pdaxrom/PYLDIN601-HD6303/docs/hdmsspi.md

# Драйвер светодиодного дисплея

Дисплей использует 4 светодиодных дисплея по 8 символов, подключенных к порту SPI.

## Запуск

`hdmsspi`

Драйвер создает символьное устройство вывода `disp`.

## Использование

Копирование текста из файла на дисплей:

`copy hello.txt disp:`
