pdaxrom/PYLDIN601-HD6303/docs/README.md

# Новый Пълдин-601

Это проект 8-битного компьютера, программно совместимого с Пълдин-601 на уровне приложений. 

[Видео на Youtube](https://www.youtube.com/watch?v=-_IdSySlPXs)

IMAGE ALT TEXT HERE (https://www.youtube.com/watch?v=-_IdSySlPXs)

Проект включает в себя не только аппаратную часть, но и BIOS, системные ПЗУ, операционную систему и утилиты для работы с обновленным железом.

## Устройство компьютера

Минимальная рабочая конфигурация требует только [плату процессора](cpu-mem.md), источник питания 5 вольт и последовательный порт (с пятивольтовыми уровнями). Для полноценной работы с возможностью использования клавиатуры, дисплея, sd карты, звука, необходима [плата периферии](ext-mod.md).

[Плата процессора](cpu-mem.md)

[Плата периферии](ext-mod.md)

## Программное обеспечение

[Базовая система и системный монитор](https://pyldin.info/document/unibios_rus.htm)

[Графический редактор GD]()

[Игры]()

[Обучающие программы]()

[Операционная система UniDOS](https://pyldin.info/document/unidos_rus.htm)

[Текстовый редактор UniED](https://pyldin.info/document/unied_rus.htm)

[Утилиты](utils.md)

[Языки программирования и инструменты разработчика](devtools.md)

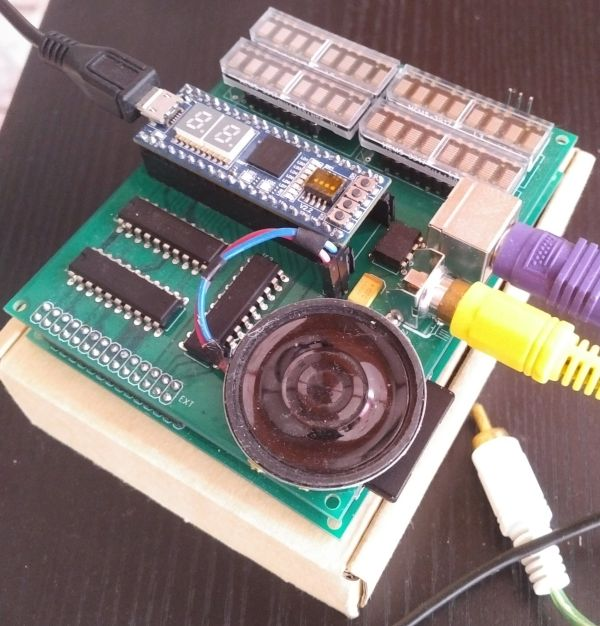
[picture p1: docs/lil-hw.jpg]
