pdaxrom/PYLDIN601-HD6303/docs/upc.md

# Компилятор UniPASCAL

## Документация

[UniPASCAL часть 1](https://pyldin.info/document/unipas_rus.htm)

[UniPASCAL часть 2](https://pyldin.info/document/unipas2_rus.htm)

## Пример

[Видео на Youtube](https://www.youtube.com/watch?v=55ygb4fnvvE)

IMAGE ALT TEXT HERE (https://www.youtube.com/watch?v=55ygb4fnvvE)
