pdaxrom/PYLDIN601-HD6303/docs/devtools.md

## Средства разработки

### Ассемблер

[UniAS](unias.md) является основным и главным системным ассемблером, поддерживающим новые команды процессора HD6303 и используется для сборки все системных прошивок ПЗУ, UniDOS и утилит.

[Ассемблер UniAS](unias.md)

[Ассемблер UniASM](https://pyldin.info/document/uniasm_rus.htm)

[Ассемблер UniCross](https://pyldin.info/document/unicross_rus.htm)

### Интерпретатор Basic

[UniBASIC](https://pyldin.info/document/unibasic_rus.htm)

### Компилятор C

[Small-C](small-c.md)

### Компилятор Паскаля

[UniPASCAL](upc.md)

### Среда разработки ТриЛого

### Среда разработки Фея
