pdaxrom/PYLDIN601-HD6303/docs/p601egrf.md

# Эмулятор графических режимов Пълдин-601

Обновленный компьютер использует другой тип видеоконтроллера и устройства видеопамяти.
Чтобы старые приложения могли корректно работать, им требуется данный эмулятор.
Текущая версия эмулятора поддерживает работу с графическими режимами, устанавливаемыми
через системные вызовы UniBIOS. Прямая работа с регистрами видеоконтроллера MC6845 не
поддерживается.

## Запуск

`p601egrf`
