pdaxrom/PYLDIN601-HD6303/docs/sdformat.md

# Форматирование SD карты

Утилита `sdformat` используется для создания файловой системы на карте памяти. Размер созданной файловой системы - 16 МБ. Для
загрузки с карты, скопируйте на нее командный интерпретатор UniDOS.CMD.

## Запуск

`sdformat`
