pdaxrom/PYLDIN601-HD6303/docs/utils.md

# Утилиты

[Драйвер светодиодного дисплея](hdmsspi.md)

[Форматирование SD карты](sdformat.md)

[Эмулятор графических режимов Пълдин-601](p601egrf.md)
