pdaxrom/PYLDIN601-HD6303/HW/hd6303-mb-ram-rom-x1.3.brd

## EAGLE design HW/hd6303-mb-ram-rom-x1.3.brd (2019-05-04)

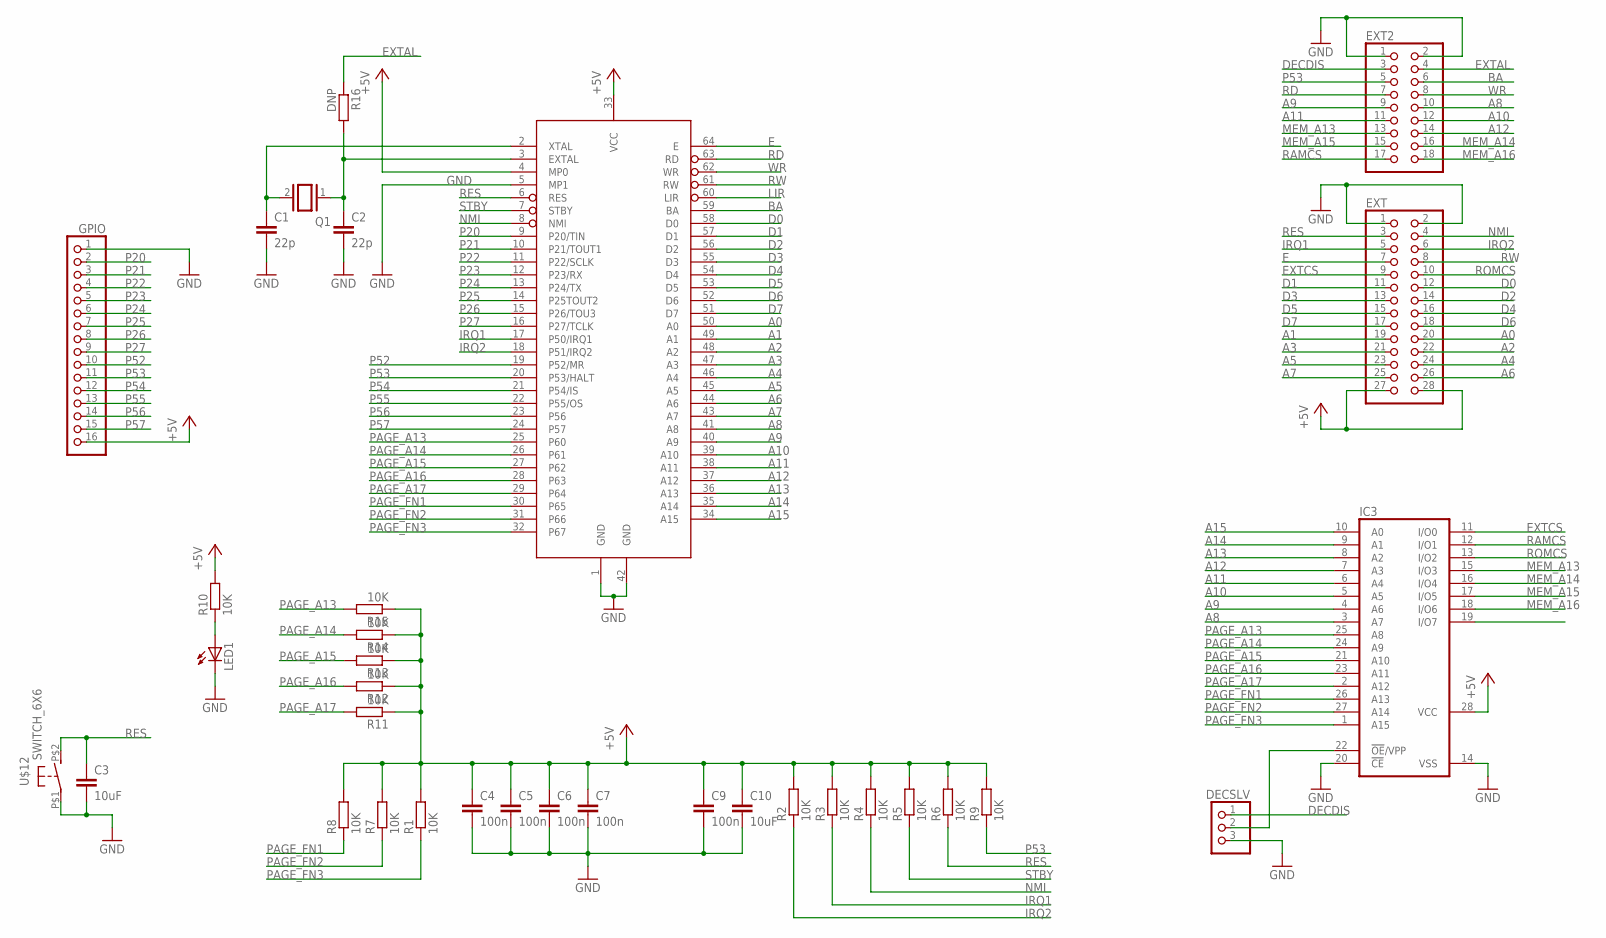
[picture p4: schematic hd6303-mb-ram-rom-x1.3.sch, sheet 1]

Parts:
C1, C2: 22p; C0603
C3, C10: 10uF; C0805
C4, C5, C6, C7, C9: 100n; C0603
DECSLV: PINHD-1X3; 1X03
EXT: PINHD-2X14; 2X14
EXT2: PINHD-2X9; 2X09
GPIO: PINHD-1X16; 1X16
IC3: 27512G; DIL28-6
LED1: LED5MM
Q1: XTAL/S; QS
R1, R2, R3, R4, R5, R6, R7, R8, R9, R10, R11, R12, R13, R14, R15: 10K; R0603
R16: DNP; R0603
U$1: HD6303YCP; DP-64S
U$12: SWITCH_6X6

Connections:
+5V: C4.1, C5.1, C6.1, C7.1, C9.1, C10.1, EXT.27, EXT.28, GPIO.16, IC3.28 (VCC), R1.2, R2.2, R3.2, R4.2, R5.2, R6.2, R7.2, R8.2, R9.2, R10.2, R11.1, R12.1, R13.1, R14.1, R15.1, U$1.4 (MP0), U$1.33 (VCC); also elsewhere on the board
A0: EXT.20, U$1.50 (A0); also elsewhere on the board
A1: EXT.19, U$1.49 (A1); also elsewhere on the board
A2: EXT.22, U$1.48 (A2); also elsewhere on the board
A3: EXT.21, U$1.47 (A3); also elsewhere on the board
A4: EXT.24, U$1.46 (A4); also elsewhere on the board
A5: EXT.23, U$1.45 (A5); also elsewhere on the board
A6: EXT.26, U$1.44 (A6); also elsewhere on the board
A7: EXT.25, U$1.43 (A7); also elsewhere on the board
A8: EXT2.10, IC3.3 (A7), U$1.41 (A8); also elsewhere on the board
A9: EXT2.9, IC3.4 (A6), U$1.40 (A9); also elsewhere on the board
A10: EXT2.12, IC3.5 (A5), U$1.39 (A10); also elsewhere on the board
A11: EXT2.11, IC3.6 (A4), U$1.38 (A11); also elsewhere on the board
A12: EXT2.14, IC3.7 (A3), U$1.37 (A12); also elsewhere on the board
A13: IC3.8 (A2), U$1.36 (A13)
A14: IC3.9 (A1), U$1.35 (A14)
A15: IC3.10 (A0), U$1.34 (A15)
BA: EXT2.6, U$1.59 (BA)
D0: EXT.12, U$1.58 (D0); also elsewhere on the board
D1: EXT.11, U$1.57 (D1); also elsewhere on the board
D2: EXT.14, U$1.56 (D2); also elsewhere on the board
D3: EXT.13, U$1.55 (D3); also elsewhere on the board
D4: EXT.16, U$1.54 (D4); also elsewhere on the board
D5: EXT.15, U$1.53 (D5); also elsewhere on the board
D6: EXT.18, U$1.52 (D6); also elsewhere on the board
D7: EXT.17, U$1.51 (D7); also elsewhere on the board
DECDIS: DECSLV.1, EXT2.3
E: EXT.7, U$1.64 (E)
EXTAL: EXT2.4, R16.1
EXTCS: EXT.9, IC3.11 (I/O0)
GND: C1.2, C2.2, C3.2, C4.2, C5.2, C6.2, C7.2, C9.2, C10.2, DECSLV.3, EXT.1, EXT.2, EXT2.1, EXT2.2, GPIO.1, IC3.14 (VSS), IC3.20 (!CE), LED1.K (C), U$1.1 (GND), U$1.5 (MP1), U$1.42 (GND), U$12.P$1; also elsewhere on the board
IRQ1: EXT.5, R3.1, U$1.17 (P50/IRQ1)
IRQ2: EXT.6, R2.1, U$1.18 (P51/IRQ2)
LIR: U$1.60 (LIR)
MEM_A13: EXT2.13, IC3.15 (I/O3); also elsewhere on the board
MEM_A14: EXT2.16, IC3.16 (I/O4); also elsewhere on the board
MEM_A15: EXT2.15, IC3.17 (I/O5); also elsewhere on the board
MEM_A16: EXT2.18, IC3.18 (I/O6); also elsewhere on the board
unnamed: LED1.A, R10.1
unnamed: DECSLV.2, IC3.22 (!OE!/VPP)
unnamed: C1.1, Q1.2, U$1.2 (XTAL)
unnamed: C2.1, Q1.1, R16.2, U$1.3 (EXTAL)
NMI: EXT.4, R4.1, U$1.8 (NMI)
P20: GPIO.2, U$1.9 (P20/TIN)
P21: GPIO.3, U$1.10 (P21/TOUT1)
P22: GPIO.4, U$1.11 (P22/SCLK)
P23: GPIO.5, U$1.12 (P23/RX)
P24: GPIO.6, U$1.13 (P24/TX)
P25: GPIO.7, U$1.14 (P25TOUT2)
P26: GPIO.8, U$1.15 (P26/TOU3)
P27: GPIO.9, U$1.16 (P27/TCLK)
P52: GPIO.10, U$1.19 (P52/MR)
P53: EXT2.5, GPIO.11, R9.1, U$1.20 (P53/HALT)
P54: GPIO.12, U$1.21 (P54/IS)
P55: GPIO.13, U$1.22 (P55/OS)
P56: GPIO.14, U$1.23 (P56)
P57: GPIO.15, U$1.24 (P57)
PAGE_A13: IC3.25 (A8), R15.2, U$1.25 (P60)
PAGE_A14: IC3.24 (A9), R14.2, U$1.26 (P61)
PAGE_A15: IC3.21 (A10), R13.2, U$1.27 (P62)
PAGE_A16: IC3.23 (A11), R12.2, U$1.28 (P63)
PAGE_A17: IC3.2 (A12), R11.2, U$1.29 (P64)
PAGE_FN1: IC3.26 (A13), R8.1, U$1.30 (P65)
PAGE_FN2: IC3.27 (A14), R7.1, U$1.31 (P66)
PAGE_FN3: IC3.1 (A15), R1.1, U$1.32 (P67)
RAMCS: EXT2.17, IC3.12 (I/O1); also elsewhere on the board
RD: EXT2.7, U$1.63 (RD); also elsewhere on the board
RES: C3.1, EXT.3, R6.1, U$1.6 (RES), U$12.P$2 (S)
ROMCS: EXT.10, IC3.13 (I/O2); also elsewhere on the board
RW: EXT.8, U$1.61 (RW)
STBY: R5.1, U$1.7 (STBY)
WR: EXT2.8, U$1.62 (WR); also elsewhere on the board

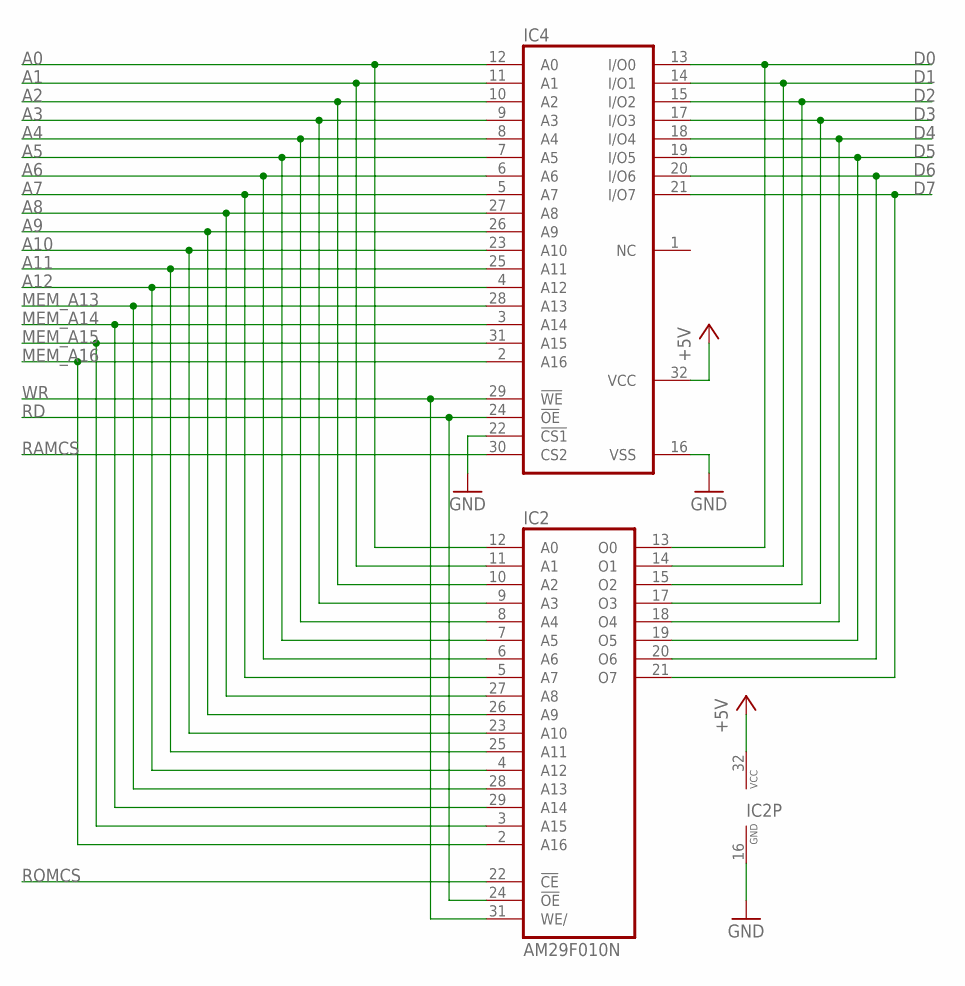
[picture p5: schematic hd6303-mb-ram-rom-x1.3.sch, sheet 2]

Parts:
IC2: AM29F010N; DIP32
IC4: 628128P; DIL32

Connections:
+5V: IC2.32 (VCC), IC4.32 (VCC); also elsewhere on the board
A0: IC2.12 (A0), IC4.12 (A0); also elsewhere on the board
A1: IC2.11 (A1), IC4.11 (A1); also elsewhere on the board
A2: IC2.10 (A2), IC4.10 (A2); also elsewhere on the board
A3: IC2.9 (A3), IC4.9 (A3); also elsewhere on the board
A4: IC2.8 (A4), IC4.8 (A4); also elsewhere on the board
A5: IC2.7 (A5), IC4.7 (A5); also elsewhere on the board
A6: IC2.6 (A6), IC4.6 (A6); also elsewhere on the board
A7: IC2.5 (A7), IC4.5 (A7); also elsewhere on the board
A8: IC2.27 (A8), IC4.27 (A8); also elsewhere on the board
A9: IC2.26 (A9), IC4.26 (A9); also elsewhere on the board
A10: IC2.23 (A10), IC4.23 (A10); also elsewhere on the board
A11: IC2.25 (A11), IC4.25 (A11); also elsewhere on the board
A12: IC2.4 (A12), IC4.4 (A12); also elsewhere on the board
D0: IC2.13 (O0), IC4.13 (I/O0); also elsewhere on the board
D1: IC2.14 (O1), IC4.14 (I/O1); also elsewhere on the board
D2: IC2.15 (O2), IC4.15 (I/O2); also elsewhere on the board
D3: IC2.17 (O3), IC4.17 (I/O3); also elsewhere on the board
D4: IC2.18 (O4), IC4.18 (I/O4); also elsewhere on the board
D5: IC2.19 (O5), IC4.19 (I/O5); also elsewhere on the board
D6: IC2.20 (O6), IC4.20 (I/O6); also elsewhere on the board
D7: IC2.21 (O7), IC4.21 (I/O7); also elsewhere on the board
GND: IC2.16 (GND), IC4.16 (VSS), IC4.22 (!CS1); also elsewhere on the board
MEM_A13: IC2.28 (A13), IC4.28 (A13); also elsewhere on the board
MEM_A14: IC2.29 (A14), IC4.3 (A14); also elsewhere on the board
MEM_A15: IC2.3 (A15), IC4.31 (A15); also elsewhere on the board
MEM_A16: IC2.2 (A16), IC4.2 (A16); also elsewhere on the board
RAMCS: IC4.30 (CS2); also elsewhere on the board
RD: IC2.24 (!OE), IC4.24 (!OE); also elsewhere on the board
ROMCS: IC2.22 (!CE); also elsewhere on the board
WR: IC2.31 (WE/), IC4.29 (!WE); also elsewhere on the board

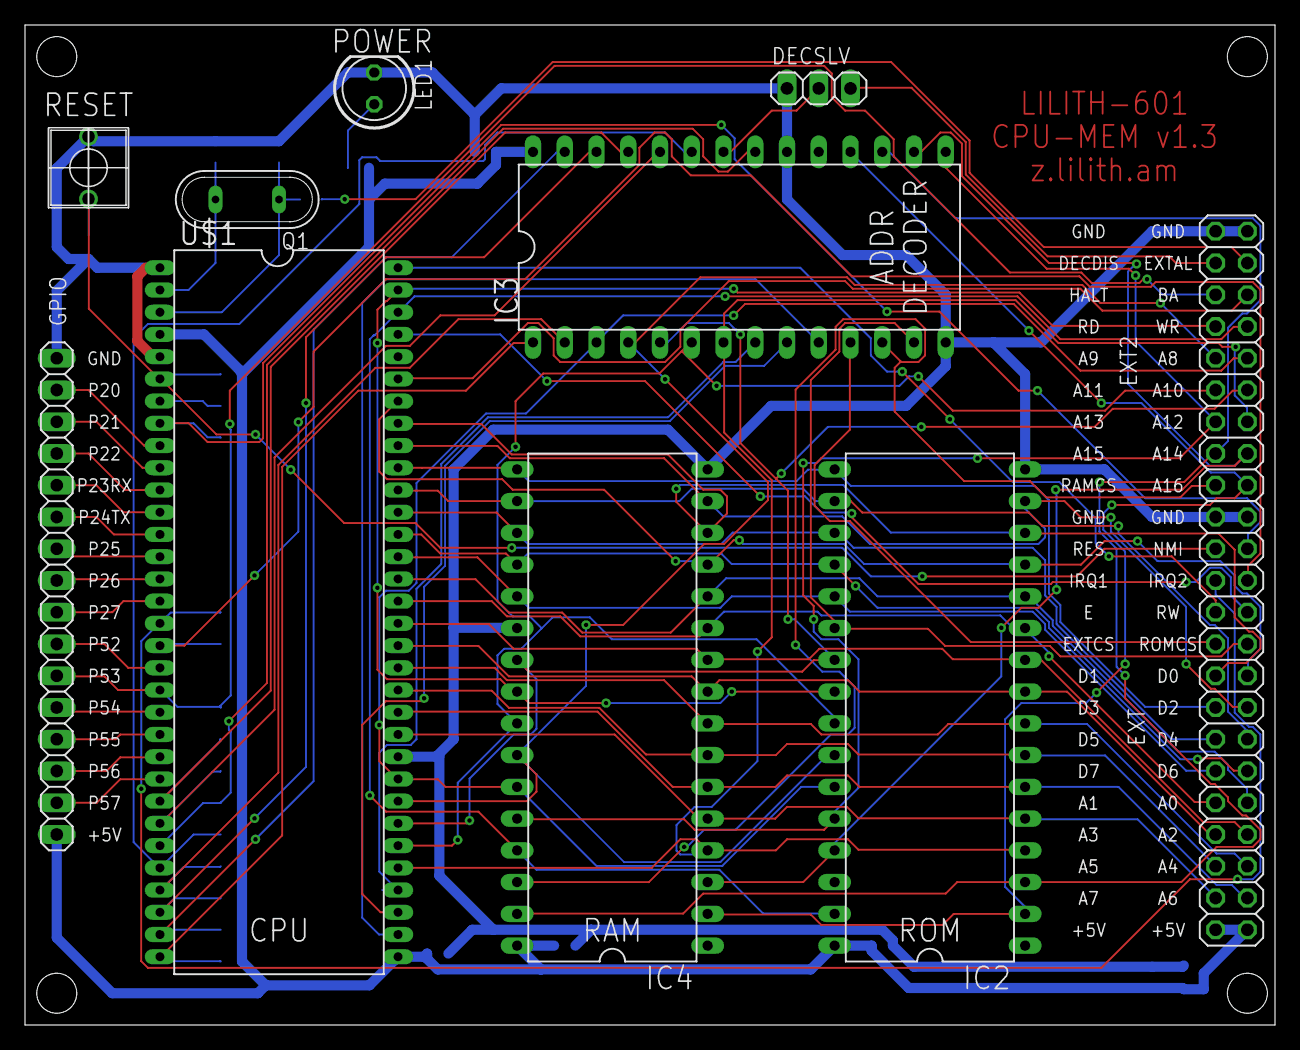
[picture p6: board hd6303-mb-ram-rom-x1.3.brd from above]

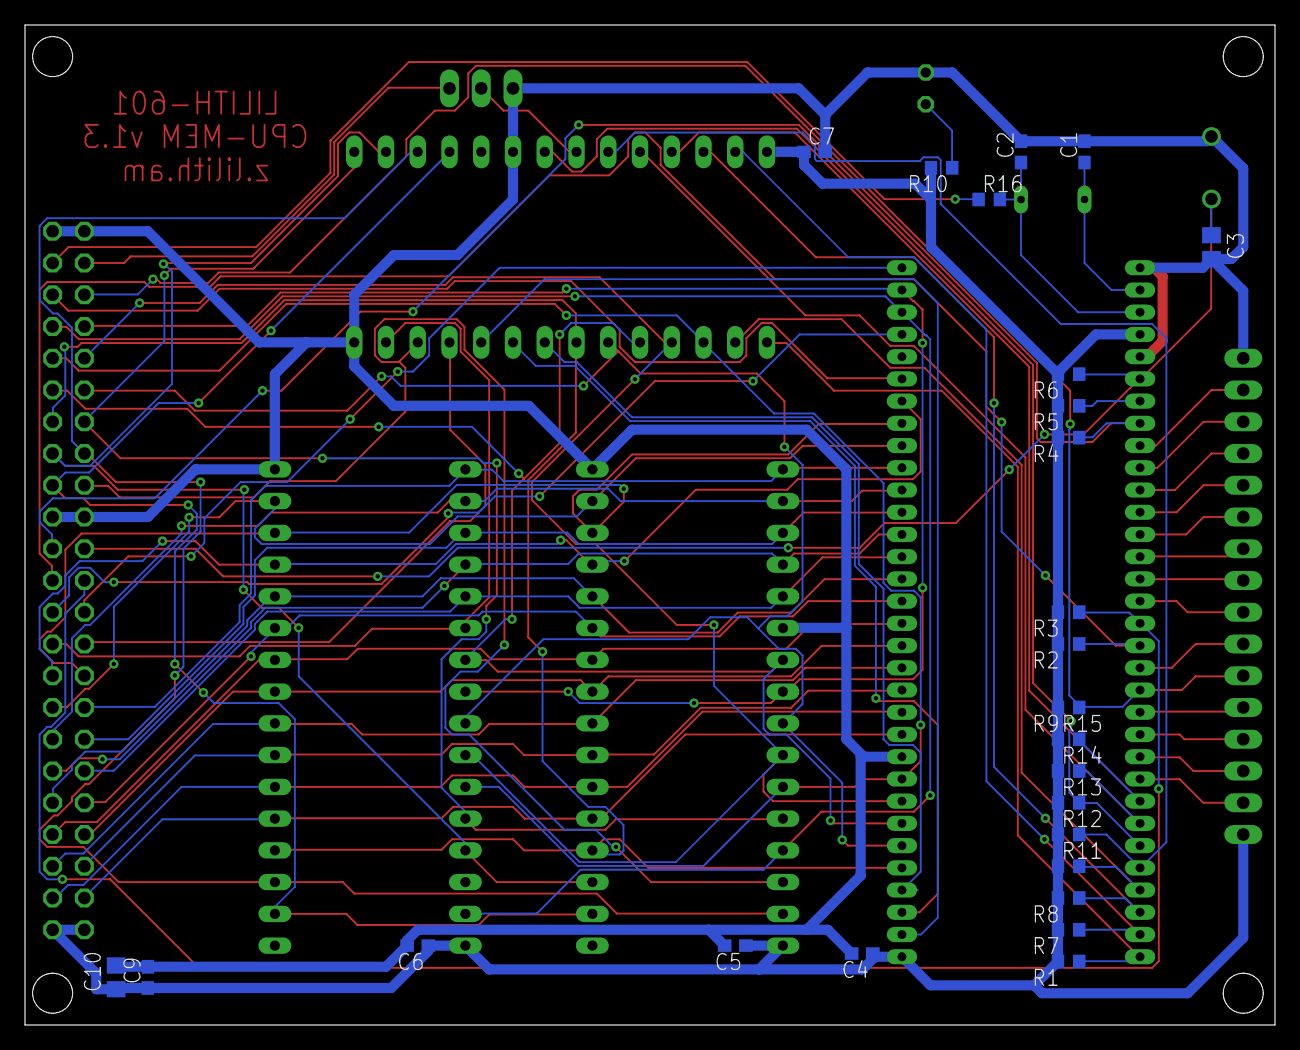
[picture p7: board hd6303-mb-ram-rom-x1.3.brd from below]

Board: 2 copper layers, 100.0 x 80.0 mm, 36 parts (25 on the bottom side), 71 nets.
