pdaxrom/PYLDIN601-HD6303/HW/hd6303-exp-x1.brd

## EAGLE design HW/hd6303-exp-x1.brd (2019-05-04)

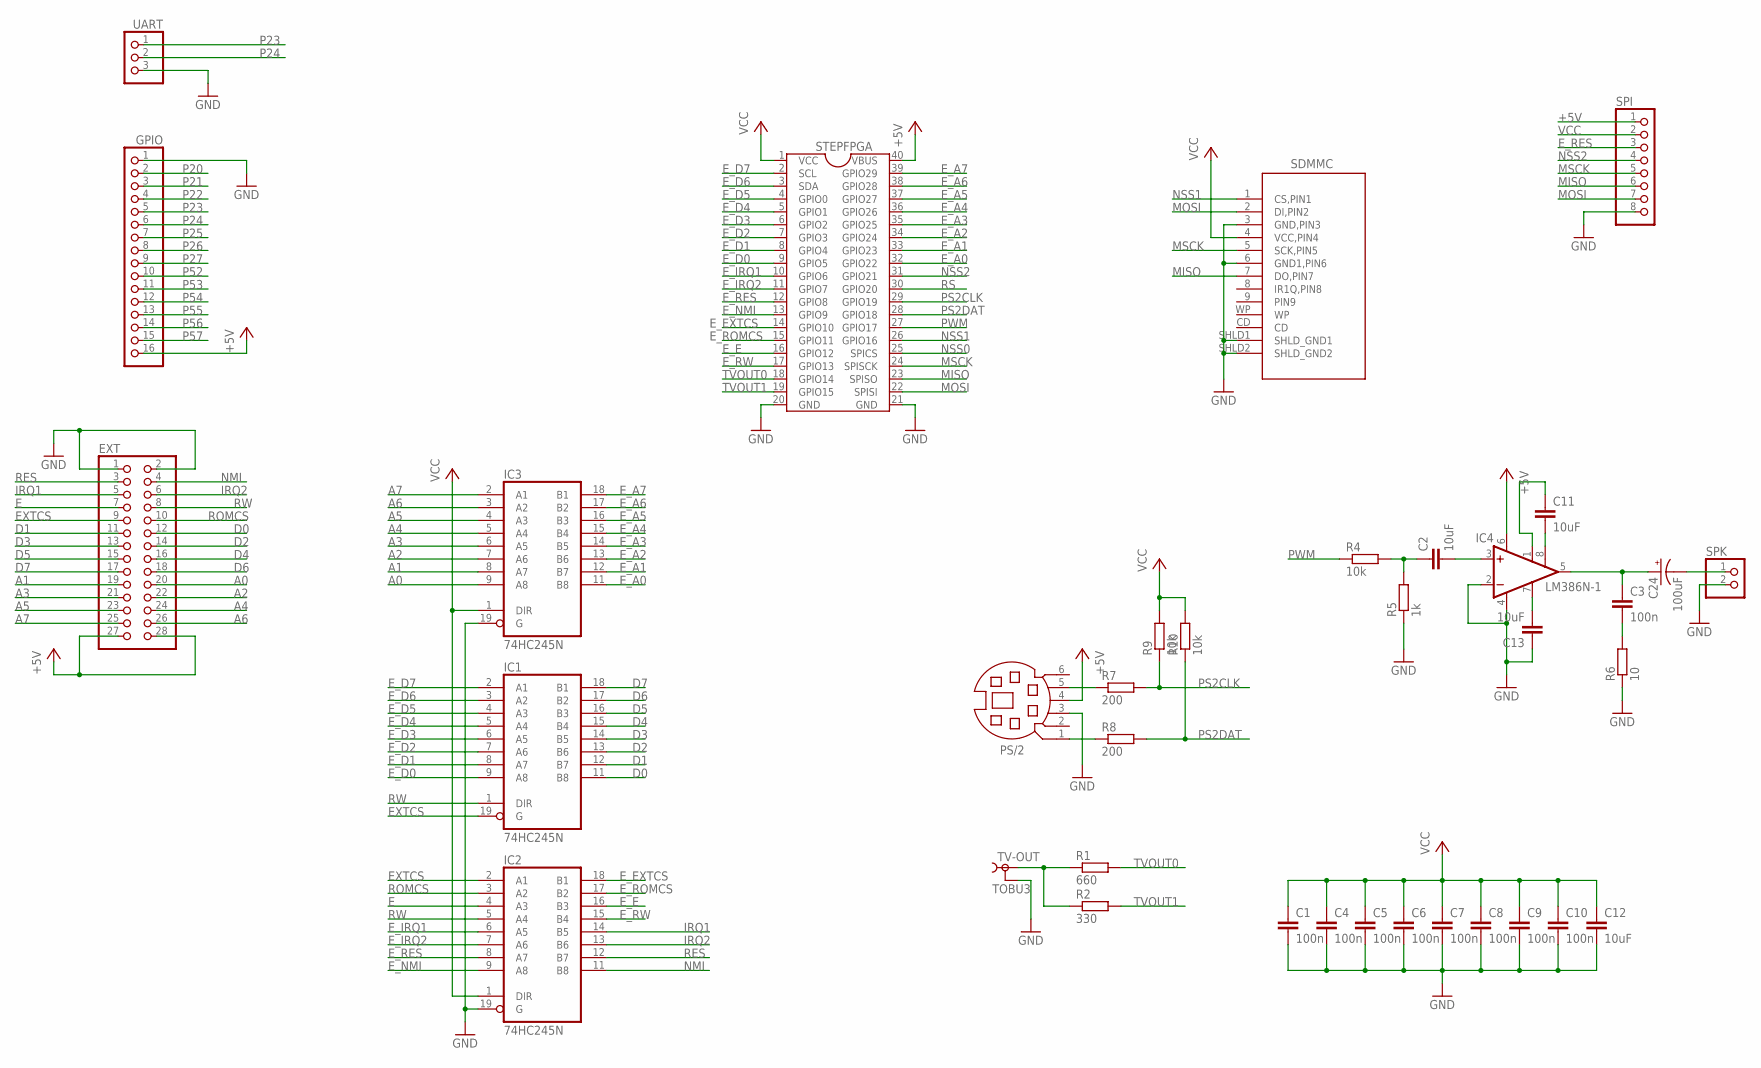
[picture p8: schematic hd6303-exp-x1.sch, sheet 1]

Parts:
C1, C3, C4, C5, C6, C7, C8, C9, C10: 100n; C0603
C2, C11, C12, C13: 10uF; C0805
C24: 100uF; EIA7343
EXT: PINHD-2X14; 2X14
GPIO: PINHD-1X16; 1X16
IC1, IC2, IC3: 74HC245N; DIL20
IC4: LM386N-1; DIL08
PS/2: MD06SS; MDIN06SS
R1: 660; R0603
R2: 330; R0603
R4, R9, R10: 10k; R0603
R5: 1k; R0603
R6: 10; R0603
R7, R8: 200; R0603
SDMMC: FCI_SD_SOCKET; SD-MMC_SOCKET-PP
SPI: PINHD-1X8; 1X08
SPK: PINHD-1X2; 1X02
STEPFPGA: STEPFPGA; DIL40
TV-OUT: TOBU3
UART: PINHD-1X3; 1X03

Connections:
+5V: EXT.27, EXT.28, GPIO.16, IC4.6 (VS), PS/2.4, SPI.1, STEPFPGA.40 (VBUS)
A0: EXT.20, IC3.9 (A8)
A1: EXT.19, IC3.8 (A7)
A2: EXT.22, IC3.7 (A6)
A3: EXT.21, IC3.6 (A5)
A4: EXT.24, IC3.5 (A4)
A5: EXT.23, IC3.4 (A3)
A6: EXT.26, IC3.3 (A2)
A7: EXT.25, IC3.2 (A1)
D0: EXT.12, IC1.11 (B8)
D1: EXT.11, IC1.12 (B7)
D2: EXT.14, IC1.13 (B6)
D3: EXT.13, IC1.14 (B5)
D4: EXT.16, IC1.15 (B4)
D5: EXT.15, IC1.16 (B3)
D6: EXT.18, IC1.17 (B2)
D7: EXT.17, IC1.18 (B1)
E: EXT.7, IC2.4 (A3)
EXTCS: EXT.9, IC1.19 (G), IC2.2 (A1)
E_A0: IC3.11 (B8), STEPFPGA.32 (GPIO22)
E_A1: IC3.12 (B7), STEPFPGA.33 (GPIO23)
E_A2: IC3.13 (B6), STEPFPGA.34 (GPIO24)
E_A3: IC3.14 (B5), STEPFPGA.35 (GPIO25)
E_A4: IC3.15 (B4), STEPFPGA.36 (GPIO26)
E_A5: IC3.16 (B3), STEPFPGA.37 (GPIO27)
E_A6: IC3.17 (B2), STEPFPGA.38 (GPIO28)
E_A7: IC3.18 (B1), STEPFPGA.39 (GPIO29)
E_D0: IC1.9 (A8), STEPFPGA.9 (GPIO5)
E_D1: IC1.8 (A7), STEPFPGA.8 (GPIO4)
E_D2: IC1.7 (A6), STEPFPGA.7 (GPIO3)
E_D3: IC1.6 (A5), STEPFPGA.6 (GPIO2)
E_D4: IC1.5 (A4), STEPFPGA.5 (GPIO1)
E_D5: IC1.4 (A3), STEPFPGA.4 (GPIO0)
E_D6: IC1.3 (A2), STEPFPGA.3 (SDA)
E_D7: IC1.2 (A1), STEPFPGA.2 (SCL)
E_E: IC2.16 (B3), STEPFPGA.16 (GPIO12)
E_EXTCS: IC2.18 (B1), STEPFPGA.14 (GPIO10)
E_IRQ1: IC2.6 (A5), STEPFPGA.10 (GPIO6)
E_IRQ2: IC2.7 (A6), STEPFPGA.11 (GPIO7)
E_NMI: IC2.9 (A8), STEPFPGA.13 (GPIO9)
E_RES: IC2.8 (A7), SPI.3, STEPFPGA.12 (GPIO8); also elsewhere on the board
E_ROMCS: IC2.17 (B2), STEPFPGA.15 (GPIO11)
E_RW: IC2.15 (B4), STEPFPGA.17 (GPIO13)
GND: C1.2, C4.2, C5.2, C6.2, C7.2, C8.2, C9.2, C10.2, C12.2, C13.1, EXT.1, EXT.2, GPIO.1, IC1.10 (GND), IC2.10 (GND), IC2.19 (G), IC3.10 (GND), IC3.19 (G), IC4.2 (-IN), IC4.4 (GND), PS/2.3, R5.1, R6.1, SDMMC.3 (GND,PIN3), SDMMC.6 (GND1,PIN6), SDMMC.SHLD1 (SHLD_GND1), SDMMC.SHLD2 (SHLD_GND2), SPI.8, SPK.2, STEPFPGA.20 (GND), STEPFPGA.21 (GND), TV-OUT.2, TV-OUT.2@1 (2), TV-OUT.2@2 (2), UART.3; also elsewhere on the board
IRQ1: EXT.5, IC2.14 (B5)
IRQ2: EXT.6, IC2.13 (B6)
MISO: SDMMC.7 (DO,PIN7), SPI.6, STEPFPGA.23 (SPISO)
MOSI: SDMMC.2 (DI,PIN2), SPI.7, STEPFPGA.22 (SPISI); also elsewhere on the board
MSCK: SDMMC.5 (SCK,PIN5), SPI.5, STEPFPGA.24 (SPISCK); also elsewhere on the board
unnamed: C2.2, IC4.3 (+IN)
unnamed: C2.1, R4.2, R5.2
unnamed: R1.1, R2.1, TV-OUT.1
unnamed: C3.1, C24.A (+), IC4.5 (OUT)
unnamed: C3.2, R6.2
unnamed: C11.1, IC4.1 (GAIN)
unnamed: C11.2, IC4.8 (GAIN)
unnamed: C24.C (-), SPK.1
unnamed: C13.2, IC4.7 (BYPASS)
unnamed: PS/2.5, R7.1
unnamed: PS/2.1, R8.1
NMI: EXT.4, IC2.11 (B8)
NSS0: STEPFPGA.25 (SPICS); also elsewhere on the board
NSS1: SDMMC.1 (CS,PIN1), STEPFPGA.26 (GPIO16)
NSS2: SPI.4, STEPFPGA.31 (GPIO21)
P20: GPIO.2
P21: GPIO.3
P22: GPIO.4
P23: GPIO.5, UART.1
P24: GPIO.6, UART.2
P25: GPIO.7
P26: GPIO.8
P27: GPIO.9
P52: GPIO.10
P53: GPIO.11
P54: GPIO.12
P55: GPIO.13
P56: GPIO.14
P57: GPIO.15
PS2CLK: R7.2, R9.1, STEPFPGA.29 (GPIO19)
PS2DAT: R8.2, R10.1, STEPFPGA.28 (GPIO18)
PWM: R4.1, STEPFPGA.27 (GPIO17)
RES: EXT.3, IC2.12 (B7)
ROMCS: EXT.10, IC2.3 (A2)
RS: STEPFPGA.30 (GPIO20); also elsewhere on the board
RW: EXT.8, IC1.1 (DIR), IC2.5 (A4)
TVOUT0: R1.2, STEPFPGA.18 (GPIO14)
TVOUT1: R2.2, STEPFPGA.19 (GPIO15)
VCC: C1.1, C4.1, C5.1, C6.1, C7.1, C8.1, C9.1, C10.1, C12.1, IC1.20 (VCC), IC2.1 (DIR), IC2.20 (VCC), IC3.1 (DIR), IC3.20 (VCC), R9.2, R10.2, SDMMC.4 (VCC,PIN4), SPI.2, STEPFPGA.1 (VCC); also elsewhere on the board

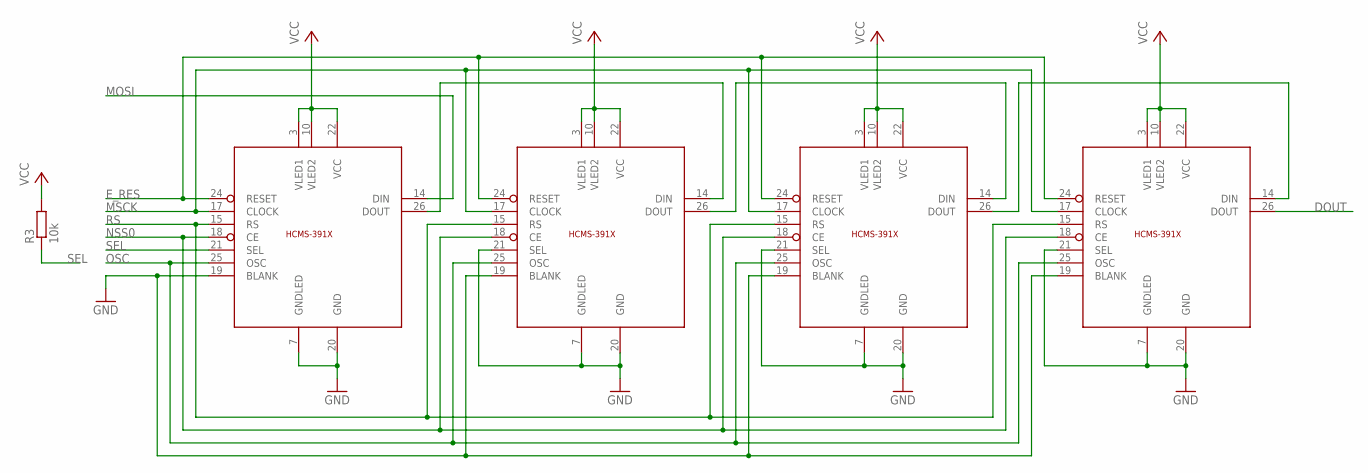
[picture p9: schematic hd6303-exp-x1.sch, sheet 2]

Parts:
R3: 10k; R0603
U$1, U$2, U$3, U$4: HCMS-391X

Connections:
DOUT: U$4.26 (DOUT)
E_RES: U$1.24 (RESET), U$2.24 (RESET), U$3.24 (RESET), U$4.24 (RESET); also elsewhere on the board
GND: U$1.7 (GNDLED), U$1.19 (BLANK), U$1.20 (GND), U$2.7 (GNDLED), U$2.19 (BLANK), U$2.20 (GND), U$2.21 (SEL), U$3.7 (GNDLED), U$3.19 (BLANK), U$3.20 (GND), U$3.21 (SEL), U$4.7 (GNDLED), U$4.19 (BLANK), U$4.20 (GND), U$4.21 (SEL); also elsewhere on the board
MOSI: U$1.14 (DIN); also elsewhere on the board
MSCK: U$1.17 (CLOCK), U$2.17 (CLOCK), U$3.17 (CLOCK), U$4.17 (CLOCK); also elsewhere on the board
unnamed: U$1.26 (DOUT), U$2.14 (DIN)
unnamed: U$2.26 (DOUT), U$3.14 (DIN)
unnamed: U$3.26 (DOUT), U$4.14 (DIN)
NSS0: U$1.18 (CE), U$2.18 (CE), U$3.18 (CE), U$4.18 (CE); also elsewhere on the board
OSC: U$1.25 (OSC), U$2.25 (OSC), U$3.25 (OSC), U$4.25 (OSC)
RS: U$1.15 (RS), U$2.15 (RS), U$3.15 (RS), U$4.15 (RS); also elsewhere on the board
SEL: R3.1, U$1.21 (SEL)
VCC: R3.2, U$1.3 (VLED1), U$1.10 (VLED2), U$1.22 (VCC), U$2.3 (VLED1), U$2.10 (VLED2), U$2.22 (VCC), U$3.3 (VLED1), U$3.10 (VLED2), U$3.22 (VCC), U$4.3 (VLED1), U$4.10 (VLED2), U$4.22 (VCC); also elsewhere on the board

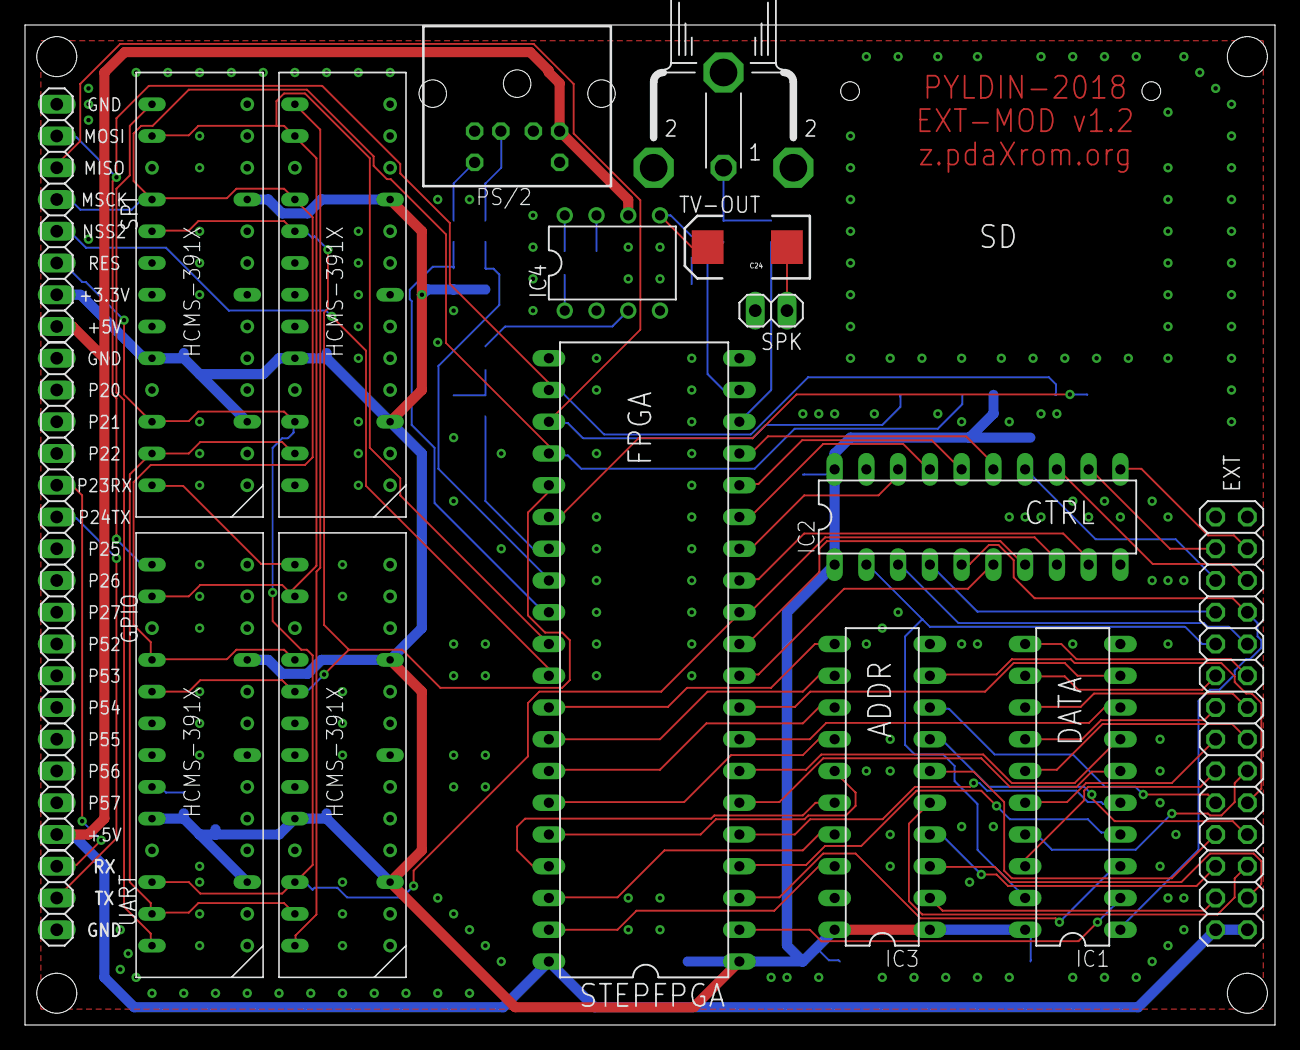
[picture p10: board hd6303-exp-x1.brd from above]

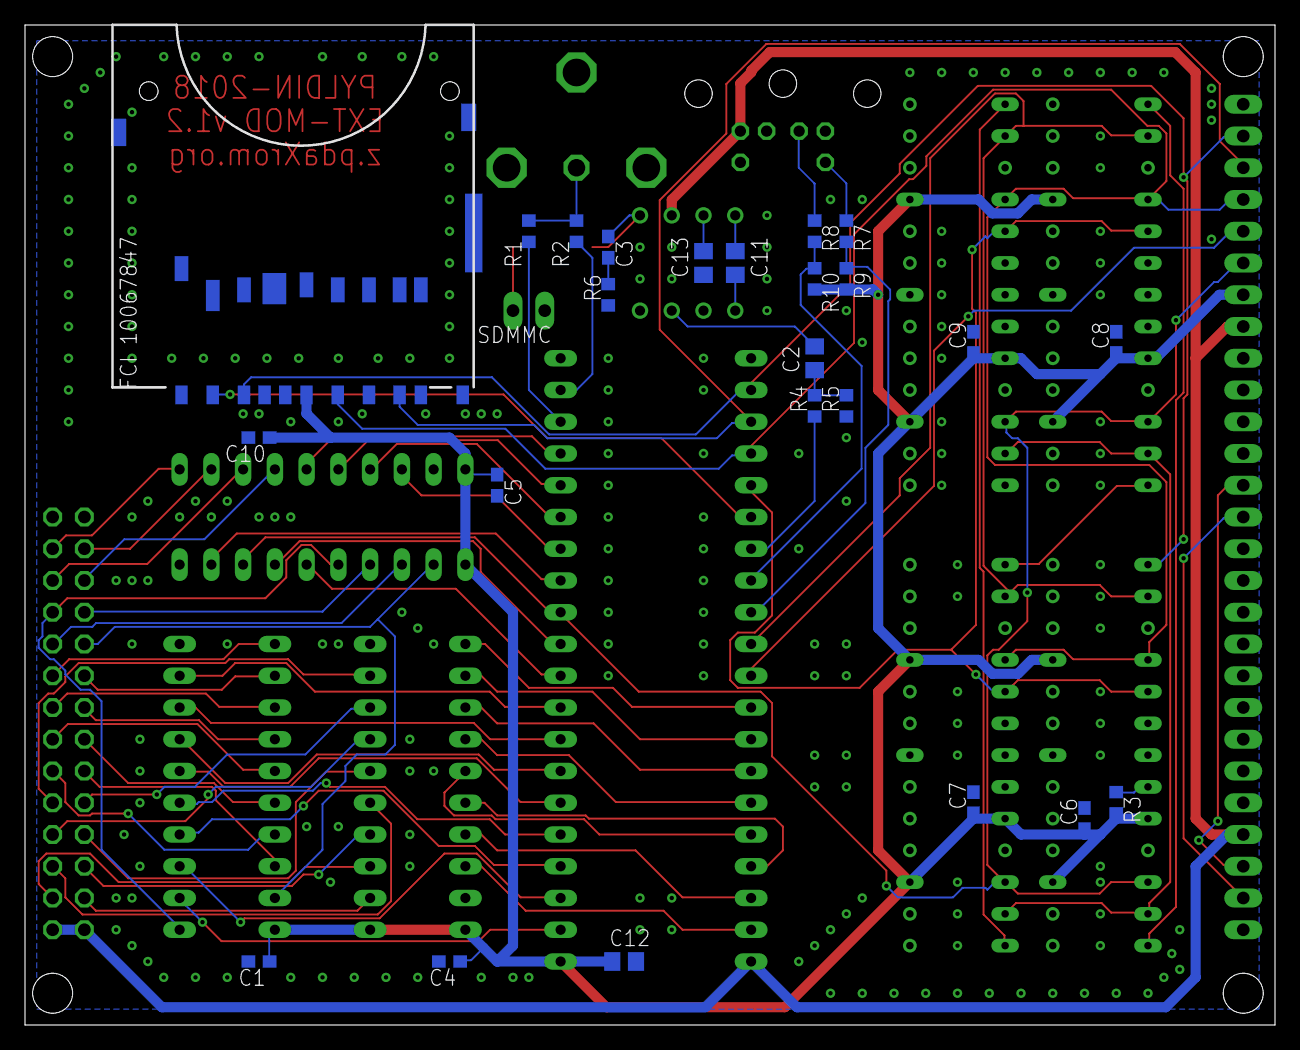
[picture p11: board hd6303-exp-x1.brd from below]

Board: 2 copper layers, 100.0 x 80.0 mm, 41 parts (24 on the bottom side), 81 nets.
