pdaxrom/PYLDIN601-HD6303/(commit log)

2018-12-25 pullup for page_a13-page_a17, fixed decoder rom
    [hd6303-exp-x1.brd, hd6303-exp-x1.sch, hd6303-mb-ram-rom-x1.brd, hd6303-mb-ram-rom-x1.sch]
2018-12-25 fixed read/write for simpleio
    [simpleio.v]
2018-12-26 fixed missed nets
    [hd6303-exp-x1.brd, hd6303-exp-x1.sch]
2018-12-30 cursor horizontal position fix
    [vpu.v]
2018-12-30 clear shift register to prevent wrong pixels in new line
    [vpu.v]
2019-01-03 working ps2 keyboard (device2host, host2device)
2019-01-16 text mode initial fixes
    [ZBIOS.ASM]
2019-01-16 separate includes for memory and devices
2019-01-16 reset keyboard and leds
2019-01-17 remove unimplemented printer int
2019-01-18 int F9-FF - HD6303Y extra interrupts
2019-01-18 fixed UniDOS kernel and serial bootloader
    [U.ASM, ZBIOS.ASM]
2019-01-18 sd/mmc driver
2019-01-19 unibios data moved from zero page, broken music functions
    [FLASHBIOS.ASM, FLASHROM.ASM, LOADBIOS.ASM, U.ASM, UNIBIOS.ASM, ZBIOS.ASM]
2019-01-20 move vpu to to prevent of write incorrect data from non native apps
    [superio.v]
2019-01-26 Trap interrupt demo
2019-01-30 uart chiptune
2019-01-30 led driver
2019-01-31 CTRL+ALT+ALT+DEL - hardware reset
    [ps2io.v, superio.v]
2019-01-31 led driver optimization
2019-02-09 6500 assembler
2019-02-09 native mc6801/hd6303 assembler
2019-02-13 as03 as assembler
2019-02-18 file r/w functions, pgm output for assembler
2019-02-28 char driver for hcms display
2019-03-09 correct spi timing
2019-03-10 peripheral interrupts router
2019-03-10 interrupt router sample
2019-03-11 removed low level samples for mcu rom
2019-03-11 cpu-mem board photo
2019-03-15 use BIOS functions to screen output to prevent to call page code
    [FLASHROM.ASM]
2019-03-15 UE original
    [TPC.CFG]
2019-03-16 hw configuration switch
2019-03-16 fixed wrong mempage setup
    [ZBIOS.ASM]
2019-03-21 fixed int 7 - dont change locked page, added quit from serial bootloader
    [UNIBIOS.ASM, ZBIOS.ASM]
2019-03-28 motherboard v1.3
    [hd6303-mb-ram-rom-x1.3.brd, hd6303-mb-ram-rom-x1.3.sch]
2019-05-04 released in pcb
    [hd6303-exp-x1.brd, hd6303-exp-x1.sch, hd6303-mb-ram-rom-x1.3.brd, hd6303-mb-ram-rom-x1.brd]
